martinclausen2/Lampensteuerung/schematics/LampenSteuerung PWM.brd

## EAGLE design schematics/LampenSteuerung PWM.brd (2016-03-12)

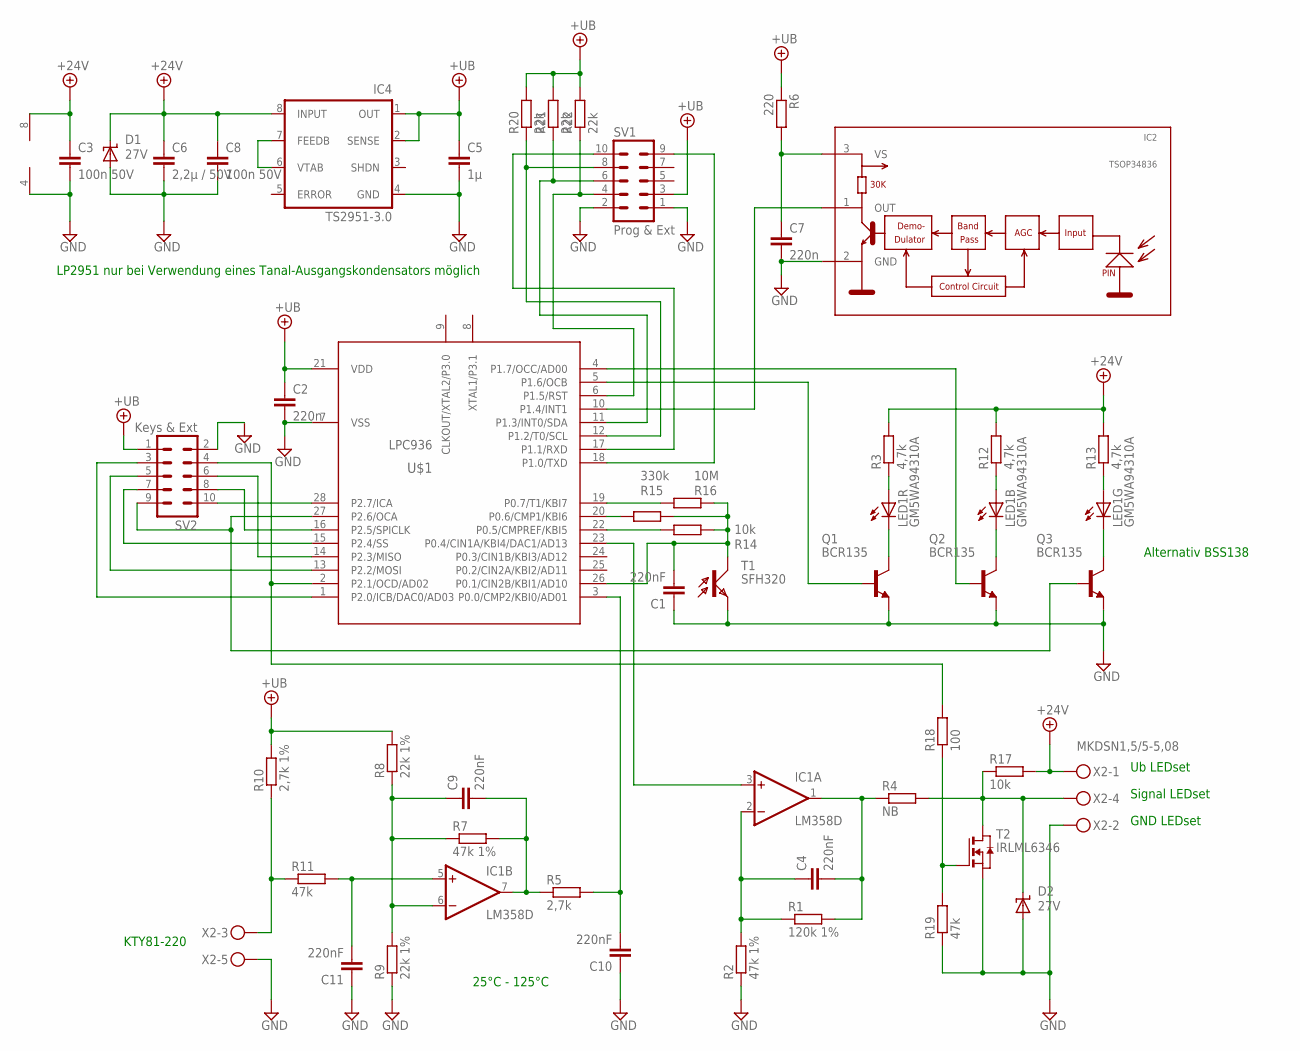
[picture p1: schematic LampenSteuerung PWM.sch]

Parts:
C1, C4, C9, C10, C11: 220nF; C0603
C2, C7: 220n; C0603
C3, C8: 100n 50V; C0603
C5: 1µ; C0805
C6: 2,2µ / 50V; C1206
D1, D2: 27V; SMBJ
IC1: LM358D; SO08
IC2: TSOP34836; TSOP348
IC4: TS2951-3.0; SO-08
LED1: GM5WA94310A
Q1, Q2, Q3: BCR135; SOT23-BEC
R1: 120k 1%; R0805
R2, R7: 47k 1%; R0805
R3, R12, R13: 4,7k; R0805
R4: NB; R0805
R5: 2,7k; R0805
R6: 220; R0805
R8, R9: 22k 1%; R0805
R10: 2,7k 1%; R0805
R11, R19: 47k; R0805
R14, R17: 10k; R0805
R15: 330k; R0805
R16: 10M; R0805
R18: 100; R0805
R20, R21, R22: 22k; R0805
SV1: Prog & Ext; MA05-2
SV2: Keys & Ext; MA05-2
T1: SFH320; PLCC2
T2: IRLML6346; SOT-23
U$1: LPC936; TSSOP28
X2: MKDSN1,5/5-5,08

Connections:
+12V: C3.1, C6.1, C8.1, D1.C, IC1.8 (V+), IC4.8 (INPUT), R3.2, R12.2, R13.2, R17.2, X2.1
+UB: C2.1, C5.1, IC4.1 (OUT), IC4.2 (SENSE), R6.1, R8.2, R10.2, R20.2, R21.2, R22.2, SV1.3, SV2.1, U$1.21 (VDD)
GND: C1.1, C2.2, C3.2, C5.2, C6.2, C7.2, C8.2, C10.1, C11.1, D1.A, D2.A, IC1.4 (V-), IC2.2 (GND), IC4.4 (GND), Q1.E, Q2.E, Q3.E, R2.1, R9.1, R19.1, SV1.1, SV1.2, SV2.2, T1.C (E), T2.2 (S), U$1.7 (VSS), X2.2, X2.5
unnamed: IC4.6 (VTAB), IC4.7 (FEEDB)
unnamed: IC2.1 (OUT), U$1.10 (P1.4/INT1)
unnamed: IC1.3 (+IN), U$1.23 (P0.4/CIN1A/KBI4/DAC1/AD13)
unnamed: C9.1, IC1.6 (-IN), R7.1, R8.1, R9.2
unnamed: LED1.5 (C), Q1.C
unnamed: C4.2, IC1.1 (OUT), R1.2, R4.1
unnamed: C4.1, IC1.2 (-IN), R1.1, R2.2
unnamed: SV1.10, U$1.17 (P1.1/RXD)
unnamed: D2.C, R4.2, R17.1, T2.1 (D), X2.4
unnamed: C7.1, IC2.3 (VS), R6.2
unnamed: SV1.9, U$1.18 (P1.0/TXD)
unnamed: LED1.6 (C), Q2.C
unnamed: R22.1, SV1.4, U$1.6 (P1.5/RST)
unnamed: LED1.1 (A), R12.1
unnamed: R20.1, SV1.8, U$1.12 (P1.2/T0/SCL)
unnamed: R21.1, SV1.6, U$1.11 (P1.3/INT0/SDA)
unnamed: C10.2, R5.2, U$1.3 (P0.0/CMP2/KBI0/AD01)
unnamed: R10.1, R11.1, X2.3
unnamed: C9.2, IC1.7 (OUT), R5.1, R7.2
unnamed: C11.2, IC1.5 (+IN), R11.2
unnamed: LED1.2 (A), R3.1
unnamed: SV2.3, U$1.1 (P2.0/ICB/DAC0/AD03)
unnamed: R18.2, SV2.4, U$1.2 (P2.1/OCD/AD02)
unnamed: SV2.5, U$1.13 (P2.2/MOSI)
unnamed: SV2.6, U$1.14 (P2.3/MISO)
unnamed: SV2.7, U$1.15 (P2.4/SS)
unnamed: SV2.8, U$1.16 (P2.5/SPICLK)
unnamed: Q3.B, SV2.9, U$1.27 (P2.6/OCA)
unnamed: SV2.10, U$1.28 (P2.7/ICA)
unnamed: LED1.3 (A), R13.1
unnamed: LED1.4 (C), Q3.C
unnamed: Q1.B, U$1.5 (P1.6/OCB)
unnamed: Q2.B, U$1.4 (P1.7/OCC/AD00)
unnamed: C1.2, R14.1, R15.1, R16.1, T1.A (C), U$1.26 (P0.1/CIN2B/KBI1/AD10)
unnamed: R16.2, U$1.19 (P0.7/T1/KBI7)
unnamed: R15.2, U$1.20 (P0.6/CMP1/KBI6)
unnamed: R14.2, U$1.22 (P0.5/CMPREF/KBI5)
unnamed: R18.1, R19.2, T2.3 (G)

Notes on the sheet:
LP2951 nur bei Verwendung eines Tanal-Ausgangskondensators möglich
Signal LEDset
Ub LEDset
GND LEDset
KTY81-220
25°C - 125°C
Alternativ BSS138

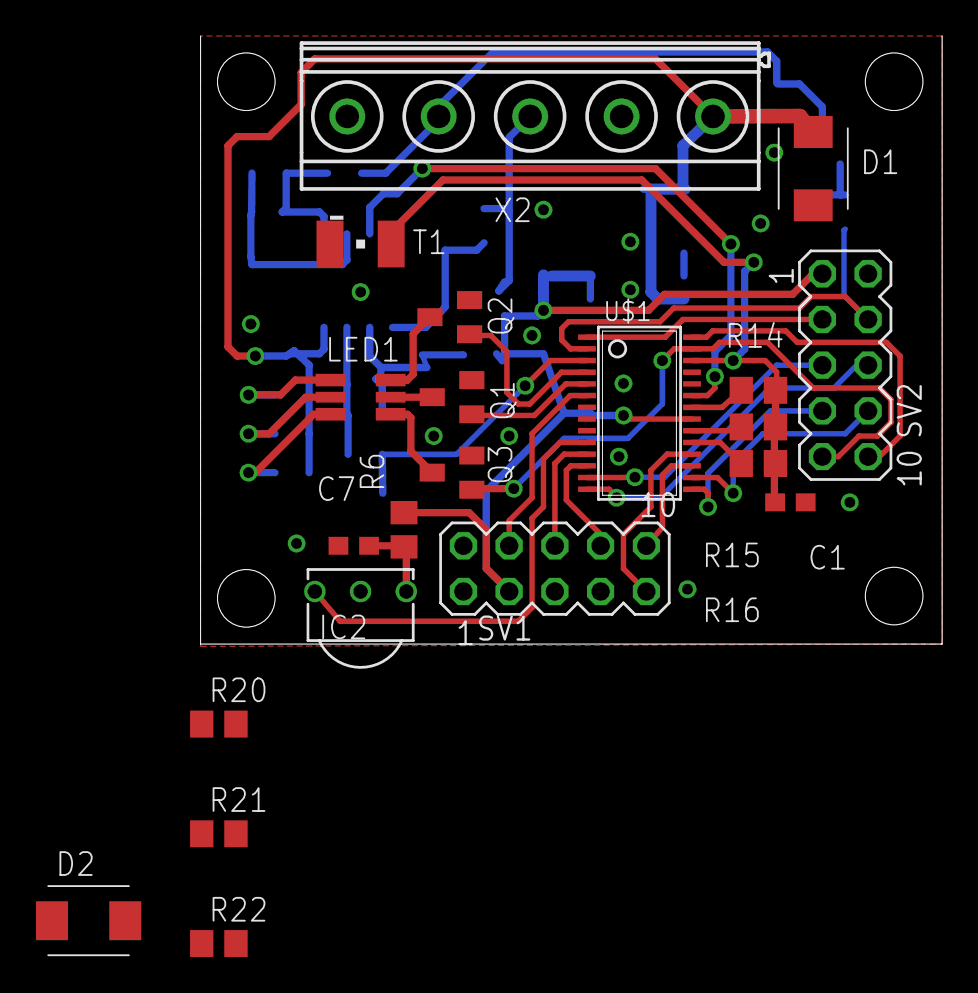
[picture p2: board LampenSteuerung PWM.brd from above]

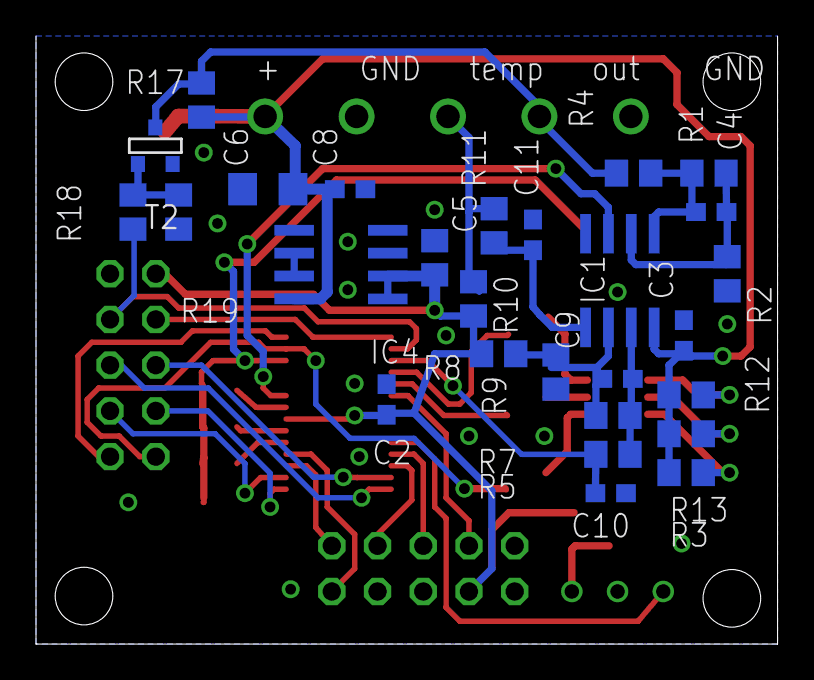
[picture p3: board LampenSteuerung PWM.brd from below]

Board: 2 copper layers, 41.2 x 33.8 mm, 48 parts (27 on the bottom side), 41 nets.
