martinclausen2/Lampensteuerung/schematics/LampenSteuerung Encoder.brd

## EAGLE design schematics/LampenSteuerung Encoder.brd (2016-03-12)

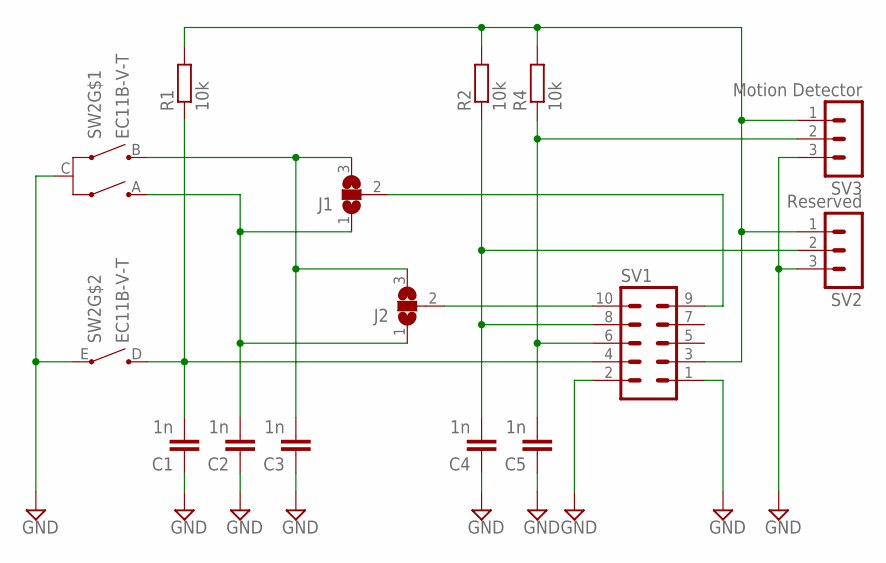
[picture p4: schematic LampenSteuerung Encoder.sch]

Parts:
C1, C2, C3, C4, C5: 1n; C0603K
J1, J2: SJ2W; SJ_2
R1, R2, R4: 10k; R0805
SV1: MA05-2
SV2: Reserved; MA03-1
SV3: Motion Detector; MA03-1
SW2: EC11B-V-T; EC11B-V

Connections:
GND: C1.1, C2.1, C3.1, C4.1, C5.1, SV1.1, SV1.2, SV2.3, SV3.3, SW2.C, SW2.E
unnamed: C1.2, R1.1, SV1.4, SW2.D
unnamed: C2.2, J1.1, J2.1, SW2.A
unnamed: C3.2, J1.3, J2.3, SW2.B
unnamed: R1.2, R2.2, R4.2, SV1.3, SV2.1, SV3.1
unnamed: C5.2, R4.1, SV1.6, SV3.2
unnamed: C4.2, R2.1, SV1.8, SV2.2
unnamed: J1.2, SV1.9
unnamed: J2.2, SV1.10

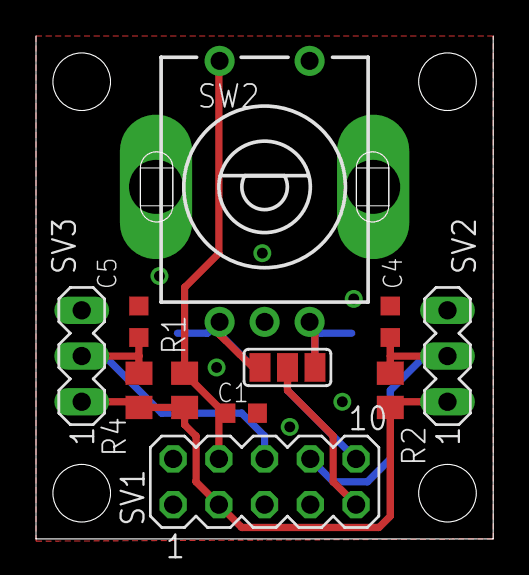
[picture p5: board LampenSteuerung Encoder.brd from above]

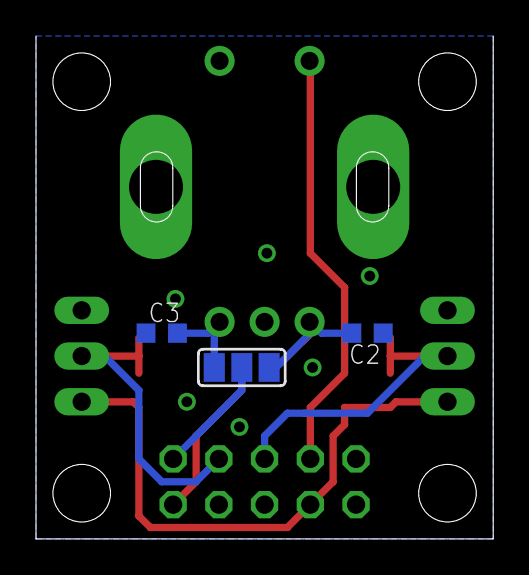
[picture p6: board LampenSteuerung Encoder.brd from below]

Board: 2 copper layers, 25.4 x 27.9 mm, 14 parts (3 on the bottom side), 9 nets.
