martinclausen2/Lampensteuerung/schematics/LampenSteuerung Driver.brd

## EAGLE design schematics/LampenSteuerung Driver.brd (2016-03-12)

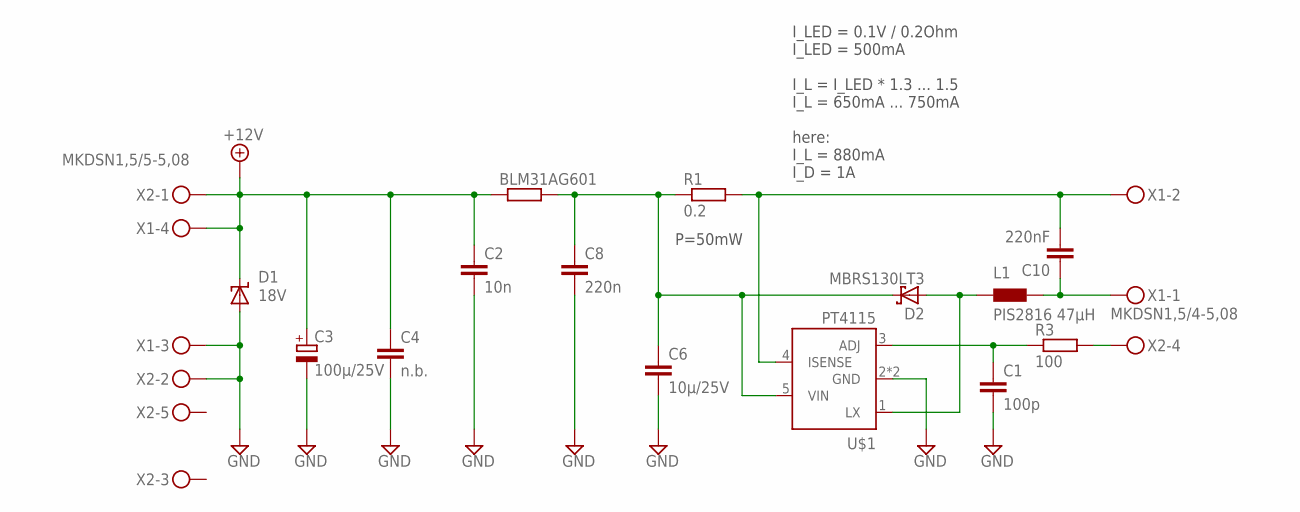
[picture p7: schematic LampenSteuerung Driver.sch]

Parts:
BLM31AG601: R-EU_R1206; R1206
C1: 100p; C0603
C2: 10n; C0603
C3: 100µ/25V; E2,5-6
C4: n.b.; C1210
C6: 10µ/25V; C1206
C8: 220n; C0603
C10: 220nF; C0603
D1: 18V; SMBJ
D2: MBRS130LT3; SMB
L1: PIS2816 47µH; PIS2816
R1: 0.2; R1206
R3: 100; R1206
U$1: PT4115; SOT89-5
X1: MKDSN1,5/4-5,08
X2: MKDSN1,5/5-5,08

Connections:
+12V: BLM31AG601.1, C2.1, C3.+, C4.1, D1.C, X1.4, X2.1
GND: C1.2, C2.2, C3.-, C4.2, C6.2, C8.2, D1.A, U$1.2 (GND), U$1.2.1 (GND), X1.3, X2.2
unnamed: C1.1, R3.1, U$1.3 (ADJ)
unnamed: C10.2, R1.2, U$1.4 (ISENSE), X1.2
unnamed: C10.1, L1.P$2, X1.1
unnamed: D2.A, L1.P$1, U$1.1 (LX)
unnamed: R3.2, X2.4
unnamed: BLM31AG601.2, C6.1, C8.1, D2.C, R1.1, U$1.5 (VIN)

Notes on the sheet:
I_LED = 0.1V / 0.2Ohm I_LED = 500mA I_L = I_LED * 1.3 ... 1.5 I_L = 650mA ... 750mA here: I_L = 880mA I_D = 1A
P=50mW

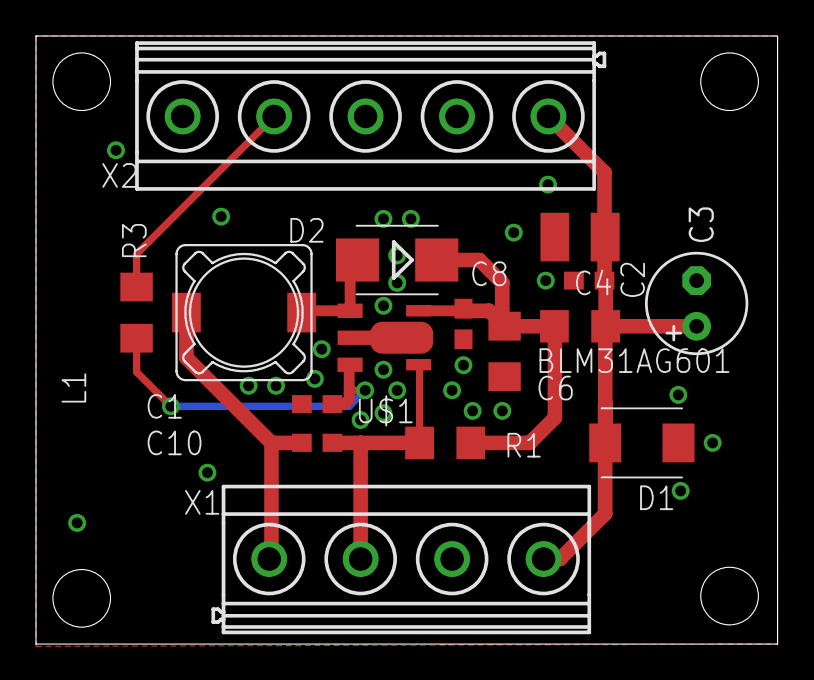
[picture p8: board LampenSteuerung Driver.brd from above]

Board: 2 copper layers, 41.2 x 33.8 mm, 16 parts (0 on the bottom side), 8 nets.
