martinclausen2/Lampensteuerung/(commit log)

2014-09-04 filled Lampensteuerung branch
    [sinewave.ods]
2014-09-12 fix missing off slope at analogue output fix spike during analogue output on fix timing
    [InitMCU.c, Keys.c, Main.c, MotionDetector.c, Options.c, Options.h, SetBrightness.c, StatusLED.h]
2014-09-14 added time slots for main loop fixed timing other small fixes
    [EEPROM.c, InitMCU.c, Keys.c, Main.c, Options.c, Options.h, RC5.c, SetBrightness.c]
2014-09-16 fix inverted PWM output
    [InitMCU.c, Main.c, Options.c, Options.h]
2014-10-08 fixed missing offset for output cleaned RC5 code, added function for number buttons fixed comments
    [InitMCU.c, Main.c, Options.c, RC5.c, SetBrightness.c]
2014-10-09 reduce power consumption of MCU
2015-09-24 - option to compile for noninverted PWM output for direct drive of LEDs - flash LED if brightness limits are reached - added comments, fixed spelling
    [GetTemperature.h, InitMCU.c, Main.c, Options.h, SetBrightness.c, StatusLED.c, StatusLED.h]
2015-09-25 - fixed led min max led flash - increased encoder acceleration
    [Encoder.c, StatusLED.c, StatusLED.h]
2015-10-01 - optimize encoder settings - fix limit led signal in options
    [Encoder.c, Main.c, SetBrightness.c, SetBrightness.h, StatusLED.c, StatusLED.h]
2015-10-01 - optimize encoder settings further
2015-10-03 - fixed flicker of output - fixed overflow in Encoder.c - use lower limit instead of zero for brightness
    [Encoder.c, InitMCU.c, Main.c, Options.c, RC5.c, SetBrightness.c, SetBrightness.h]
2015-10-03 - fix lower limit for brightness
    [Main.c, RC5.c, SetBrightness.c, SetBrightness.h]
2016-03-12 added schematics
    [LampenSteuerung PWM.brd, LampenSteuerung PWM.sch, LampenSteuerung.brd, LampenSteuerung.sch]
2016-03-12 added driver and encoder pcb
    [LampenSteuerung Driver.brd, LampenSteuerung Driver.sch, LampenSteuerung Encoder.brd, LampenSteuerung Encoder.sch, LampenSteuerung PWM.brd, LampenSteuerung PWM.sch]
2016-07-14 added dimming function for standby status led improved options status led (cleaner code, better usablity)
2019-01-28 prolonged fade out added option to switch fade out off
2021-03-28 adjust ADC settings for more precise ambient light measurement
2022-11-05 updated to SDCC 4.2.0 prolonged key press time to enter option menu to avoid unwanted entry of the options menu
    [EEPROM.c, Encoder.c, GetBrightness.c, GetTemperature.c, GetTemperature.h, InitMCU.c, Keys.c, LCD_EA_DOG_SPI.c]
2022-11-06 fix key press duration update version
    [Main.c, Options.h]
